Willena/Hardware-PoolReader/Board-Sources/BOM.csv

ID | Name | Designator | Footprint | Quantity | Manufacturer Part | Manufacturer | Supplier | Supplier Part | LCSC Assembly
1 | HDR-F-2.54_1x2 | H1_POWER | HDR-F-2.54_1X2 | 1 |  |  | LCSC | C49661
2 | 1k | R8,R9,R12,R3,R4 | R0402 | 5
3 | 200 | R10 | R0402 | 1
4 | 4k | R11,R13 | R0402 | 2
5 | 4k7 | R5 | R0402 | 1
6 | LM4140CCMX-2/NOPB | U1_PREF | SOIC-8_L4.9-W3.9-P1.27-LS6.0-BL | 1 | LM4140CCMX-2.5/NOPB | TI | LCSC | C91560 | Yes
7 | HDR-M-2.54_1x1 | 1W,P1-,P1+,P2+,P2- | HDR-M-2.54_1X1 | 5 |  |  | LCSC | C81276
8 | ATTINY85-20SU | U3_AT | SOIC-8_L5.3-W5.3-P1.27-LS8.0-BL | 1 | ATTINY85-20SU | MICROCHIP | LCSC | C89852 | Yes
9 | 0 | R2,R1 | R0402 | 2
10 | HDR-F-2.54_1x4 | H1_PRG | HDR-F-2.54_1X4 | 1 |  |  | LCSC | C225501
11 | 4.7u | C1,C2 | C0402 | 2
12 | DS18B20U+T&R | U4 | SOP-8_L3.0-W3.0-P0.65-LS4.9-BL | 1 | DS18B20U+T&R | MAXIM | LCSC | C93246
13 | TLC4502C | U1,U2 | SOP-8_L4.9-W3.9-P1.27-LS6.0-BL | 2 | TLC4502C | TI | LCSC | C45793
