Willena/Hardware-PoolReader/Board-Sources/Schematic_PoolReader.pdf

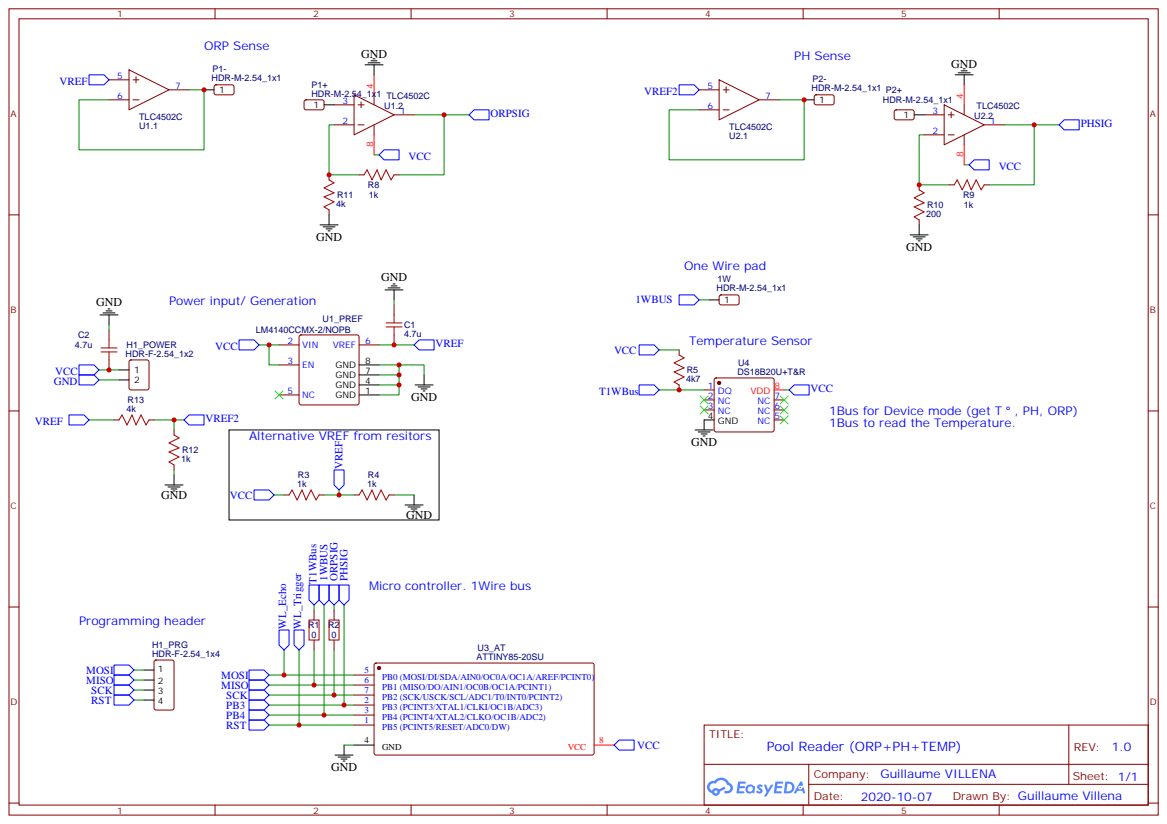
[picture p1: page 1]

VCC
1Bus for Device mode (get T , PH, ORP)
1Bus to read the Temperature.

Alternative VREF from resitors

Drawn By: Guillaume Villena
