Willena/Hardware-PoolReader/Board-Sources/PCB_ComponentPlacement.pdf

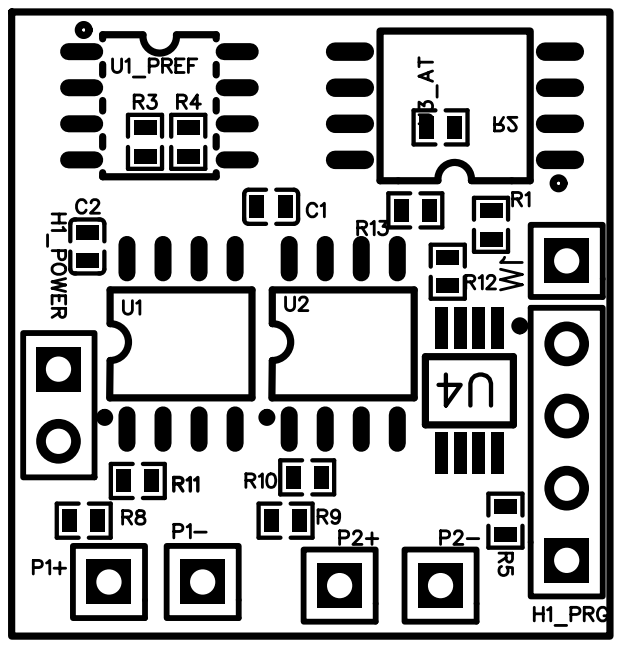
[picture p2: page 1]
