Willena/Hardware-PoolReader/Board-Sources/PCB_Back.pdf

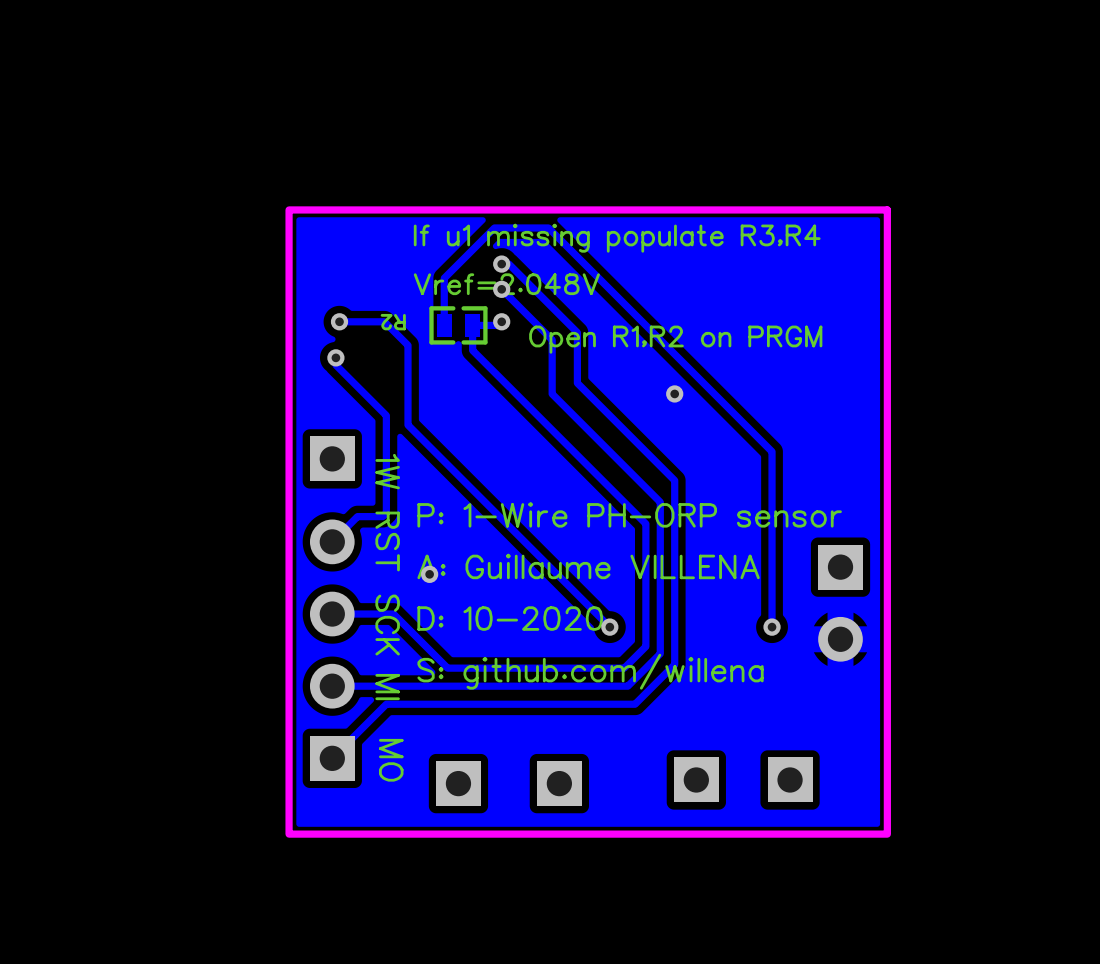
[picture p3: page 1]
