Willena/Hardware-PoolReader/Board-Sources/PCB_Front.pdf

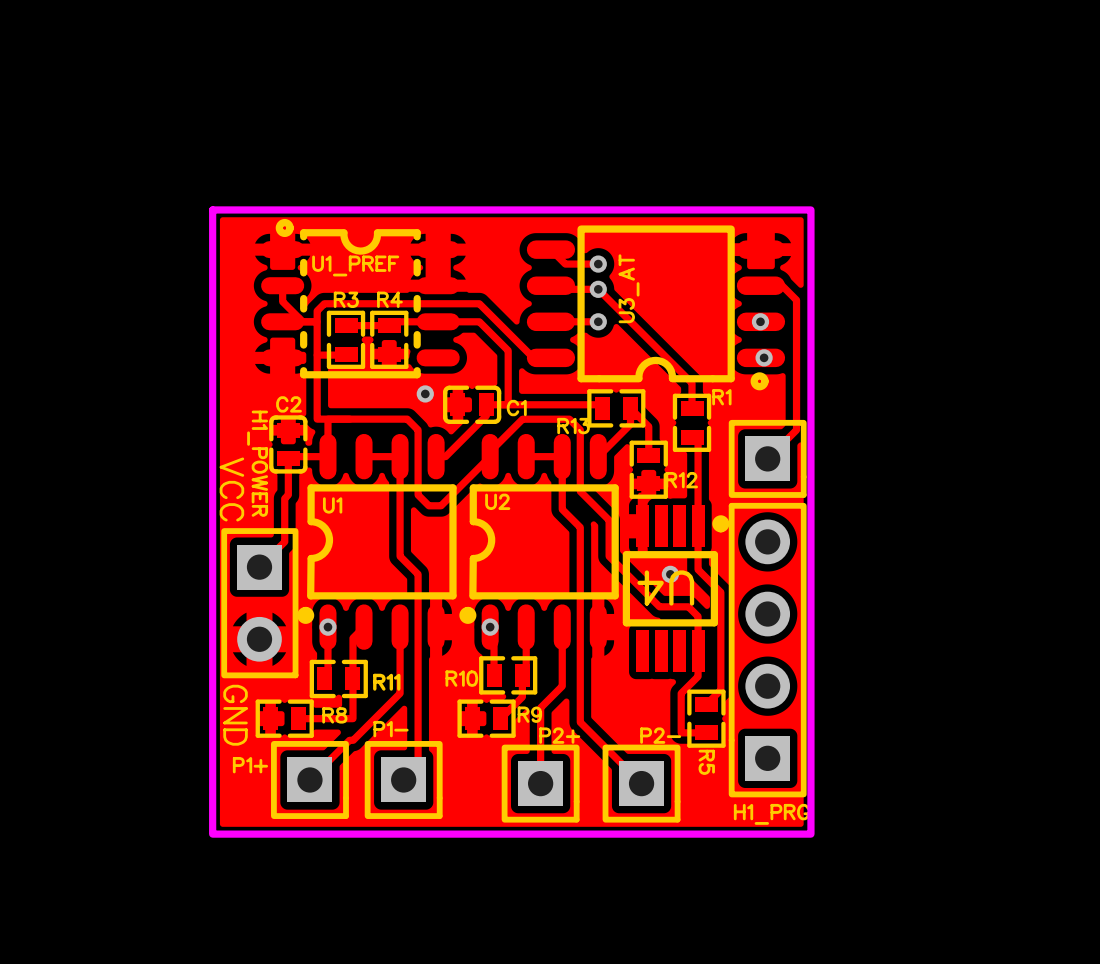
[picture p4: page 1]
